gabrielcammany/Hangman/PhaseOne/README.md

# Phase One #

Phase one main objectives are the interaction with the user and the communication with the phase two to process the game logic.

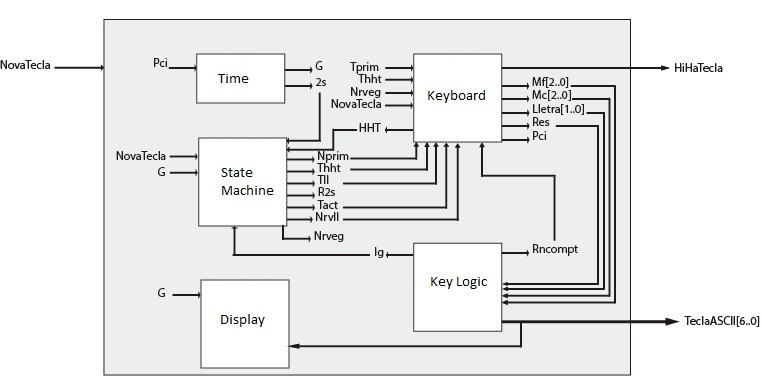
[picture p3: PhaseOne/images/Diagram.jpg]


## Time Diagram
The time diagram of the signals both generated or received, is shown below

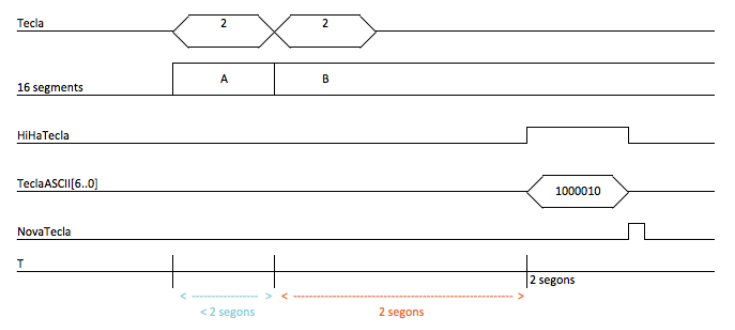
[picture p4: PhaseOne/images/TimeDiagram.PNG]


Although it is in Catalan, signals are translated as:
* HiHaTecla - Key is pressed
* NovaTecla - Phase Two input asking for a new letter
* TeclaASCII - It is the key pressed represented in ASCII

Also, have in mind that a key is only send after 2 seconds have passed since it was pressed. (As shown in orange)

## Integrated Circuits Used
* High Performance CMOS EPROM to convert from the keyboard to the ASCII letter. 
* GAL22V10 for both the state machine and the 16 segments
* 74LS TTL
  * 74LS14 - Hex Inverter with Schmitt Trigger Inputs
  * 74LS32 - OR Gates
  * 74LS74 - Dual D-Type Positive-edge-triggered flip-flops
  * 74LS173 - 4 bit d-type register with 3-state outputs
  * 74LS682 - 8-bit comparator
  * 74LS161 - Synchronous 4-bit counter
 * Ne555 oscillator

### Electric Scheme

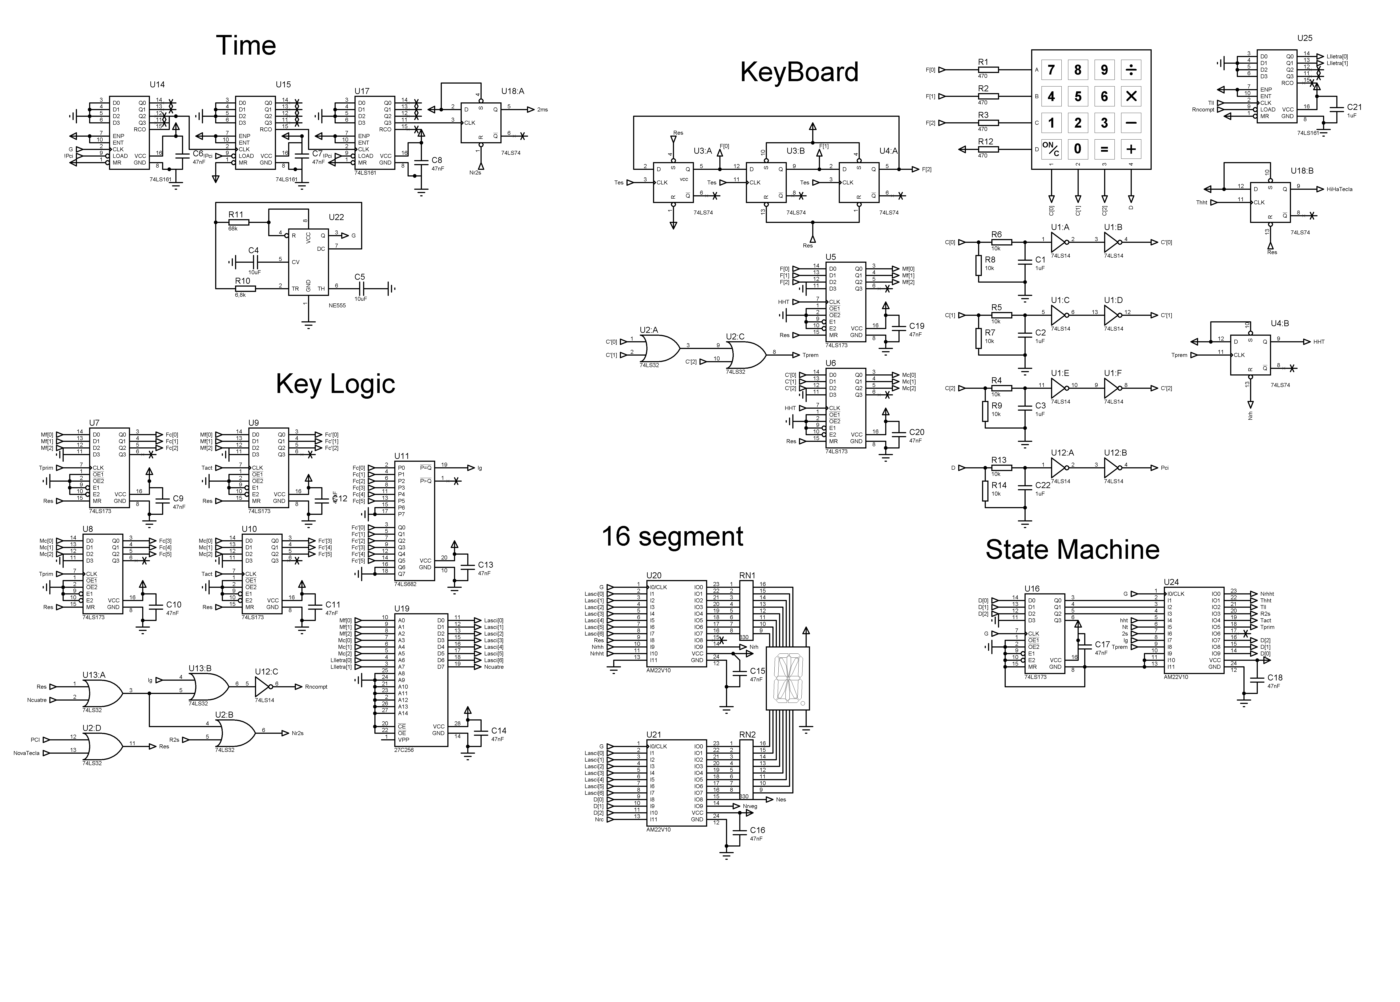
[picture p5: PhaseOne/ElectricSchemeProteus/Phase1.BMP]


## Board

Finally, this picture shows how does the Phase One looks once its soldered. (Sorry for the bad image quality, the bad lighting
and the excessive image processing of the phone camera, messed it up)

The sticker covering the EPROM is used to protect data integrity, as they are erased with ultra-violet light and 
in some cases, data gets corrupted even with normal lighting.

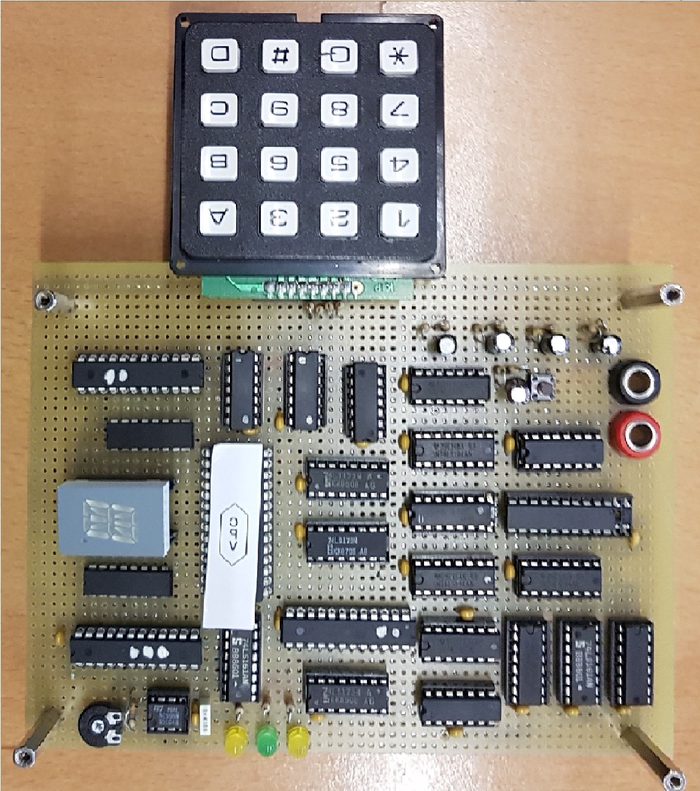
[picture p6: PhaseOne/images/PhaseOne.jpg]
