gabrielcammany/Hangman/images/Connections.jpg

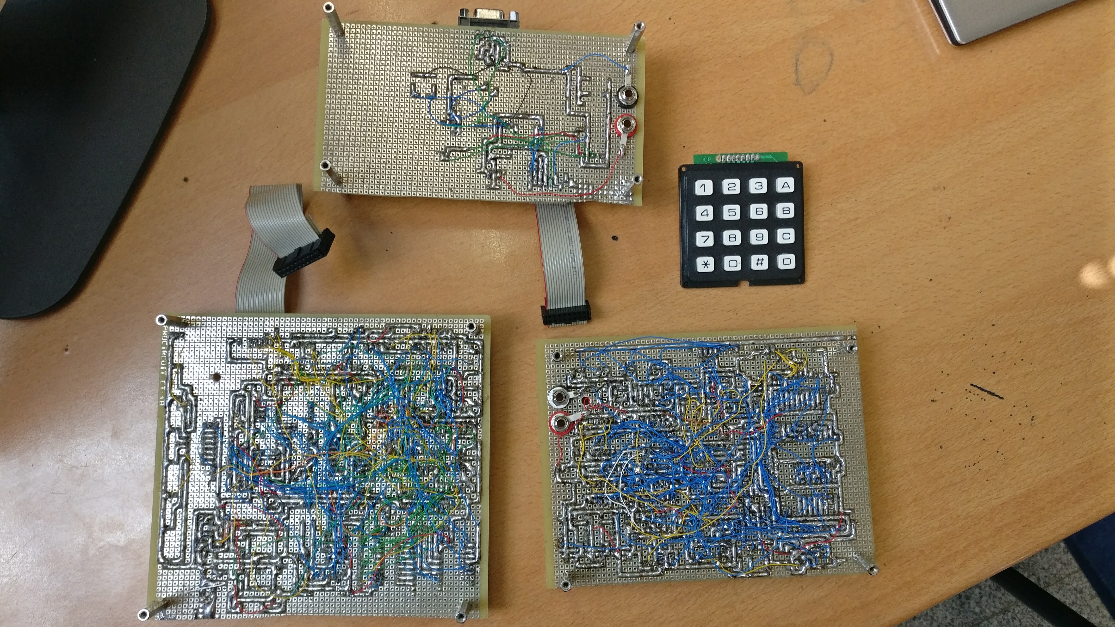
images/Connections.jpg
