gabrielcammany/Hangman/images/Lost.jpg

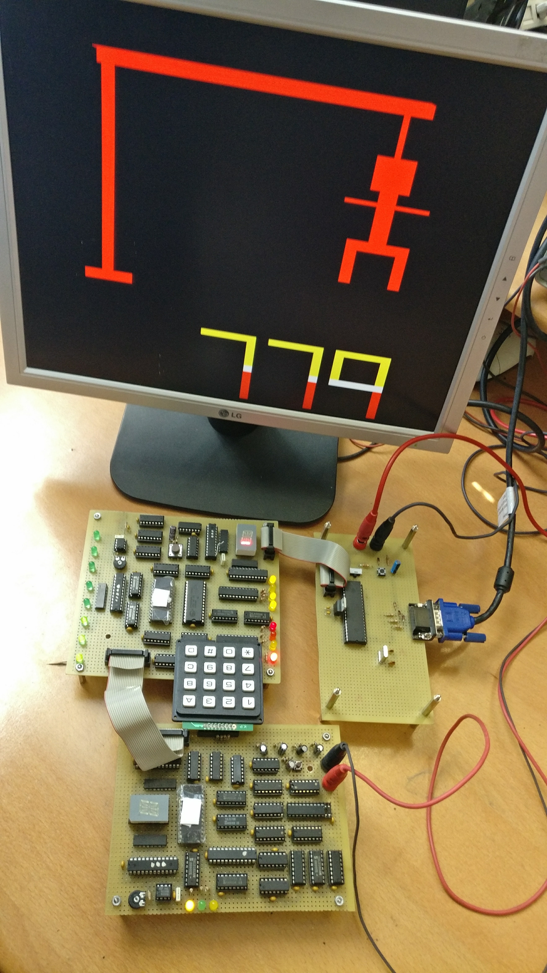
images/Lost.jpg
