gabrielcammany/Hangman/images/PhaseTwo&One.jpg

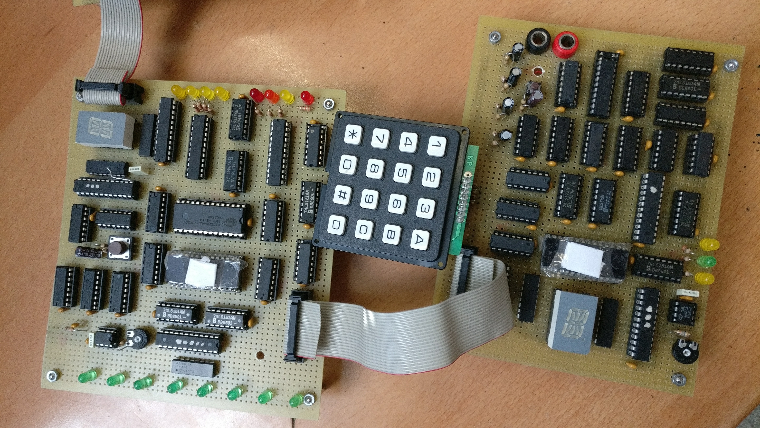
images/PhaseTwo&One.jpg
