gabrielcammany/Hangman/images/PhaseTwo&Three.jpg

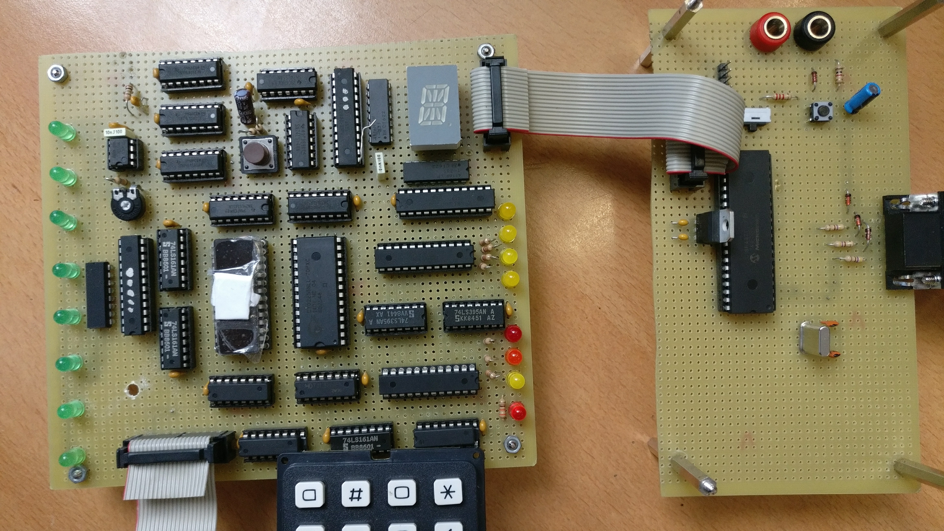
images/PhaseTwo&Three.jpg
