gabrielcammany/Hangman/images/Playing.jpg

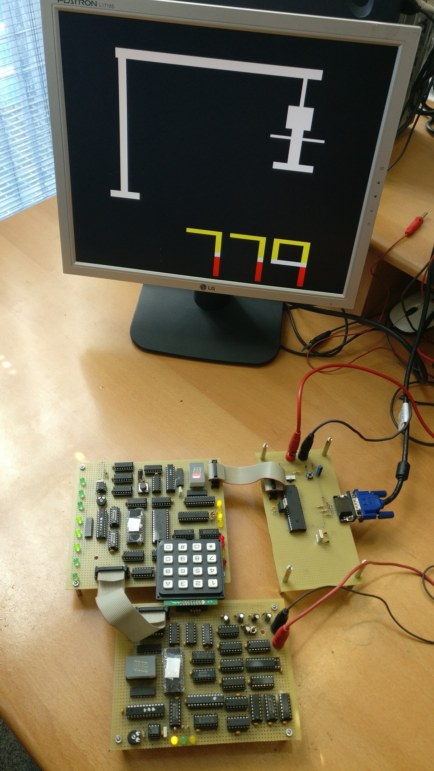
images/Playing.jpg
