gabrielcammany/Hangman/images/Won.jpg

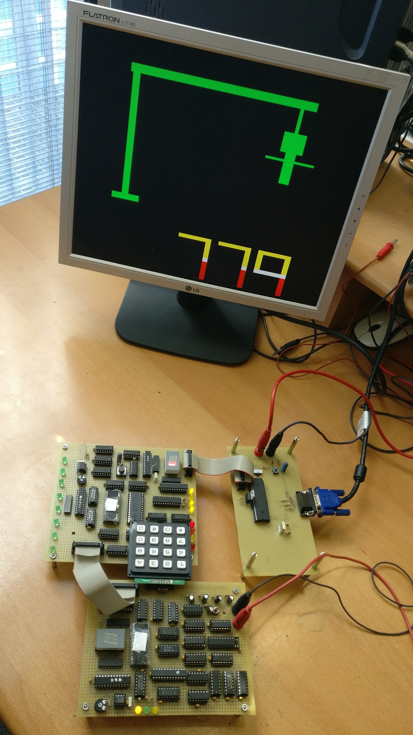
images/Won.jpg
