gabrielcammany/Hangman/PhaseOne/images/StateMachine.png

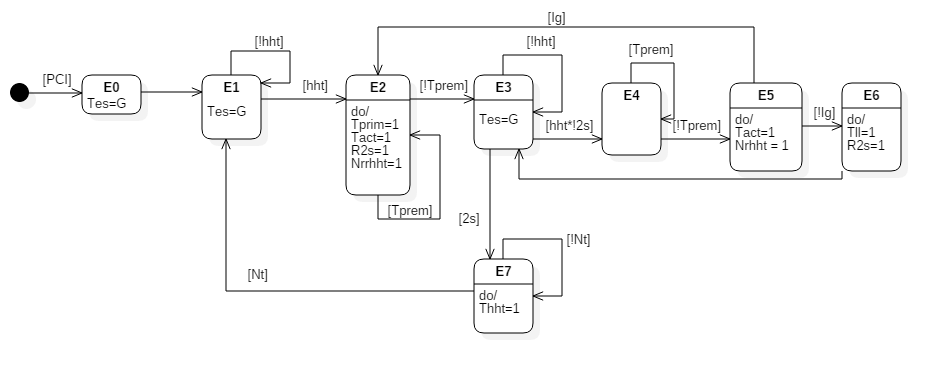
PhaseOne/images/StateMachine.png
