gabrielcammany/Hangman/(list of files, drawings)

Other design files:
PhaseOne/ElectricSchemeProteus/Phase1.pdsprj
PhaseTwo/ElectricSchemeProteus/Phase2.pdsprj
