gabrielcammany/Hangman/(commit log)

2017-02-28 Tot el dibuix fet
2017-03-03 Tot el dibuix fet v2
2017-03-06 Part inicial de comencar a mirar quines zones mostrar o no
2017-03-09 Mostrar per errors quasi fet, realitzant zona 5 per mostrar o no braços
2017-11-01 Added the other phases
    [Phase1.pdsprj, Phase2.pdsprj]
2017-11-01 More name changes
    [Phase1.pdsprj, Phase2.pdsprj]
2017-11-01 Folders name
    [Phase1.pdsprj, Phase2.pdsprj]
2017-11-01 Added LEDs logic png
